vaxdatex/Output-DIY/OUTPNL2_Montaza/OUTPNL2-layout.pdf

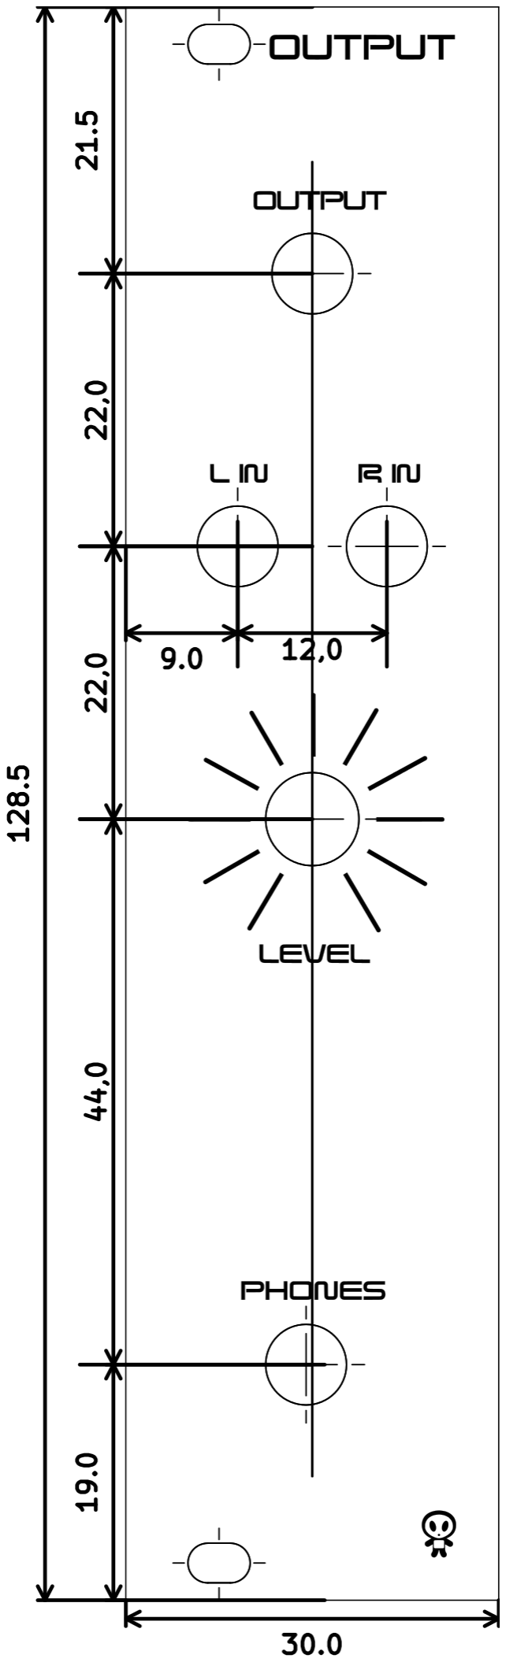
[picture p1: page 1]
