vaxdatex/Output-DIY/OUTPNL2_Montaza/OUTPNL2-layout_noDim.pdf

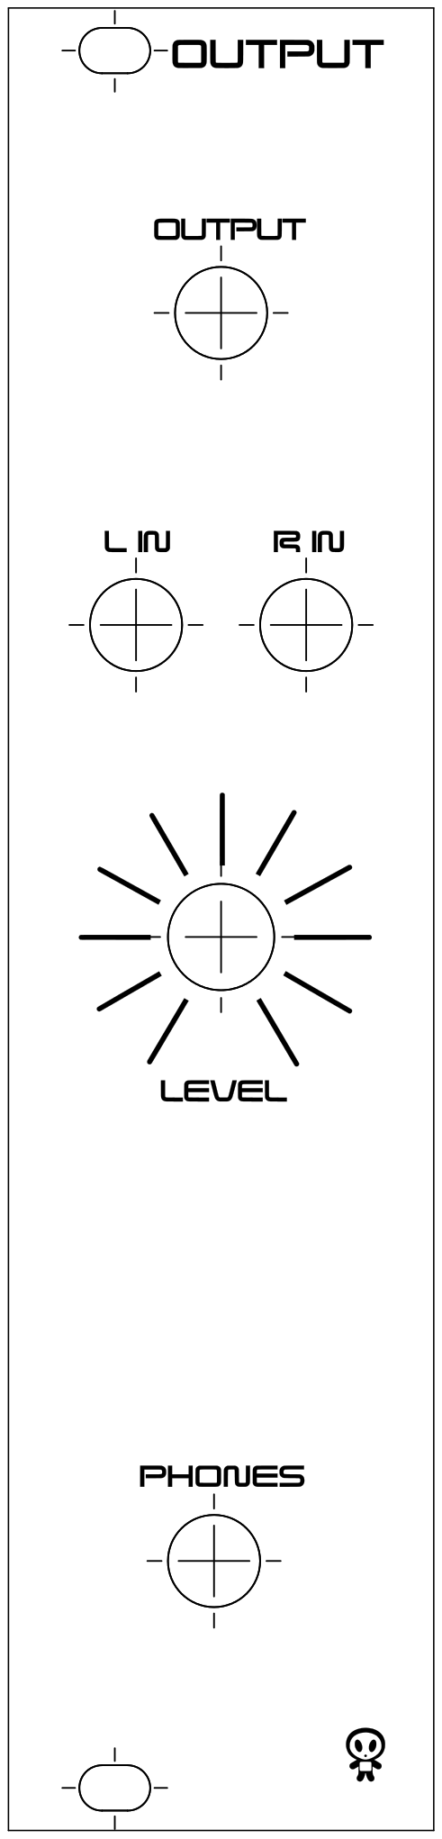
[picture p2: page 1]
