vaxdatex/Output-DIY/Controls_v4/DIYOUT4C_BOM.xls

 | Erica Synths Output module v4.0 July 2020
Id | Designator | Package | Quantity | Designation | Supplier and ref
1 | XS6,XS3,XS5,XS7 | PBS-6 | 4 | PBS-6_FEMALE
2 | VD12,VD10,VD11,VD13,VD14,VD15,VD16,VD17 | DO-35 | 8 | 1N4148
3 | C3,C6,C7,C13 | C-5mm | 4 | 0.1uF
4 | C4,C5 | C-5mm | 2 | 15pF
5 | C10,C11 | CE63x25 | 2 | 47uFx25V
6 | DA1 | TO-92 | 1 | 78L05
7 | L1,L2 | R0125W | 2 | 100uH
8 | XP1 | IDC-10MS | 1 | IDC-10MS
9 | XS1,XS2 | WQP-PJ301M-12 | 2 | WQP-PJ301M-12 | Thonk
10 | VR1,VR2 | RB090-30 | 2 | ERF-RB-090-30
11 | VD6,VD7,VD1 | DO-41 | 3 | 1N4001
12 | R1 | RD902F | 1 | B10k | Thonk, Tayda
13 | R3,R4 | R_W4_THT | 2 | 100k
14 | R15,R20 | R_W4_THT | 2 | 120k
15 | R31,R32 | R_W4_THT | 2 | 470
16 | R33,R34 | R_W4_THT | 2 | 75
17 | XS4,XS9 (stereo jack sockets!!!) | WQP-PJ366ST | 2 | WQP-PJ366ST | Thonk
 | PCB:DIYOUT4C
