vaxdatex/Output-DIY/Main_v3/DIYOUT3M_BOM.xls

 | Erica Synths Output module v3.0 June 2020
Id | Designator | Package | Quantity | Designation | Supplier and ref
1 | VD2 | DO-35 | 1 | 1N4148
2 | XP2,XP3,XP4,XP5 | PLS-6 | 4 | PLS-6_MALE
3 | C2,C1 | CE63x25_NP | 2 | 10uFx25V
4 | C8,C9,C14 | C-5mm | 3 | 0.1uF
5 | C12,C20 | CE63x25 | 2 | 2.2uFx25V
6 | C16 | CE63x25 | 1 | 1uFx25V
7 | C18,C23,C24 | CE63x25 | 3 | 100uFx25V
8 | C21,C22 | CE63x25 | 2 | 22uFx25V
9 | DA2 | DIP-14_Socket | 1 | TL074
10 | VD3,VD4,VD5 | DO-35 | 3 | 1N4148
11 | DA3 | SO-8 | 1 | LM4808
14 | R2,R13,R5,R6,R27,R28 | R_W4_THT | 6 | 100k
15 | R12,R21,R22,R11,R7,R8 | R_W4_THT | 6 | 10k
16 | R14,R17 | R_W4_THT | 2 | 3.9k
17 | R16,R18 | R_W4_THT | 2 | 10k*
18 | R23,R24 | R_W4_THT | 2 | NU
19 | R29,R30,R25,R26 | R_W4_THT | 4 | 33k
20 | R9,R10 | R_W4_THT | 2 | OPTION
 | PCB: DIYOUT3M
